djerickson/diy-smu/README.md

# diy-smu
Hardware and firmware for the DIY SMU project: Source Measure Unit
7/3 This is first attempt at Github
7/11 added Nextion
7/11 Made public
