djerickson/diy-smu/Hardware/SMU_BOM.xls

Sheet: MBoard
RefDes | Value | Name | Manufacturer | MPN | Qty | $ | $ | Notes | Availability Notes
C1, C6, C7 | 47uf 25V | CAPAE_6.6x6.6h5.7 | Panasonic | EEE-1EA470SP | 3 | $0.25 | $0.75
C2, C3, C4, C8, C12, C13, C17 | 4.7u 25V | CAP_0805 |  |  | 6 | $0.10 | $0.60 | Rev1: C17 || .1uF
C9 | 4.7u 25V 4mm |  |  | UWX1E4R7MCL1GB | 1 | $0.20 | $0.20 | High ESR: Reversed!
C5 | .01 1206 HiV | CAP_1206 |  | C1206X103MCRAC7800 | 1 | $1.00 | $1.00
C10, C18, C19, C20, C25, C27 | 1000p NPO | CAP_0805 |  |  | 6 | $0.05 | $0.30
C11, C14, C15, C16, C17, C21, C22, C23, C24, C29, C30, C31, C32, C33, C35, C36, C37, C43, C44, C45, C46, C47, C49, C50, C52 | .1u 50V | CAP_0805 |  |  | 25 | $0.02 | $0.50
C26, C28, C34 | 15p NPO | CAP_0805 |  |  | 3 | $0.10 | $0.30
C38 | 100p NPO | CAP_0805 |  |  | 1 | $0.10 | $0.10
C39, C40, C41 | 270p NPO | CAP_0805 |  |  | 3 | $0.10 | $0.30
C53 C54 | 270p NPO 500V | CAP_1206 |  | CL31C271JGFNNNE | 2 | $0.10 | $0.20
C48 | 150p NPO | CAP_0805 |  |  | 1 | $0.10 | $0.10
C51, C42 | 22p NPO 100V | CAP_0805 |  |  | 1 | $0.10 | $0.10
C55 DNI | 22p NPO 500V | CAP_1206 | Yageo | CC1206JRNPOBBN220 | 1 | $0.10 | $0.10
D1, D2 | BAV99 100V 215mA | SOT23 | ON | BAV99LT1 | 2 | $0.10 | $0.20
D3, D5, D6, D7 | BAV199 | SOT23 | Nexperia | BAV199.215 | 4 | $0.10 | $0.40 | Low Leakage, serial
D4 | BAV170 | SOT23 | Diodes | BAV170Q | 1 | $0.10 | $0.10
J1 | 14 pin box Hdr | HDRF-2x7 | On Shore Technology | 302-S141 (https://www.digikey.com/product-detail/en/on-shore-technology-inc/302-S141/ED10522-ND/2794233) | 1 | $0.50 | $0.50
J2 | 6p .1" Hdr |  | Molex KK | WM2704-ND‎ | 1 | $1.00 | $1.00
J3 | 6p .15" M |  | On Shore Technology | OSTOQ063251 (https://www.digikey.com/product-detail/en/on-shore-technology-inc/OSTOQ063251/ED2812-ND/1588129) | 1 | $1.00 | $1.00
J4 | 3p .15" M |  | On Shore Technology | OSTOQ033251 (https://www.digikey.com/product-detail/en/on-shore-technology-inc/OSTOQ063251/ED2812-ND/1588129) | 1 | $0.50 | $0.50
K2 | 1.5 ohm SW | AQY221R | Panasonic |  | 1 | $4.00 | $4.00 | 100mA range
K3 | 8 ohm SW | TLP170D | Toshiba |  | 1 | $1.50 | $1.50 | 400V 8 ohms
K1 DNI | Low ohm SW |  |  |  | 0 | $1.66 | $0.00 | For 1A range
K6 | .8 ohm SW | CPC1018N | IXYS |  | 1 | $2.00 | $2.00 | For 1.5V range
K4, K5 |  | RELAY2_DPDT | Kemet | EC2-5NU | 2 | $1.50 | $3.00 | 200V 2A DPDT
L1 | 100uH CM Choke | SRF1260A | Bourns | DR331-105 | 1 | $0.80 | $0.80 | Install L1 or FB2 and R78-80
FB1 | FB 600 ohm | RES_1210 | Taiyo Yuden | FBMH3225HM601NT | 0 | $0.25 | $0.00 | Install L1 or FB2 and R78-80
Q1, Q2 | MMBT3904 | SOT-23 | Philips-NXP | MMBT3904 | 2 | $0.10 | $0.20
R4, R5, R9, R11, R12, R13, R15, R16, R18, R19, R20, R21, R22, R23, R24, R25, R26, R54 | 10K .1% | RES_0805 |  |  | 18 | $0.10 | $1.80
R51, R52, R53, R55 | 10K .01% | RES_0805 |  |  | 4 | $0.50 | $2.00 | R53-R51 and R55-R52 0.01% matched
R1, R2, R3, R28, R33, R48, R49, R60, R61, R66 | 10K 1% | RES_0805 |  |  | 10 | $0.02 | $0.20
R68 | 10K 1% 1206 | RES_1206 |  |  | 1 | $0.05 | $0.05
R31 | 20K .1% | RES_0805 |  |  | 1 | $0.10 | $0.10
R29, R34 | 20K 1% | RES_0805 |  |  | 2 | $0.02 | $0.04
R10, R14, R17 | 21.5K .1% | RES_0805 |  |  | 3 | $0.02 | $0.06
R64, R6, R8 | 22.1K .1% | RES_0805 |  |  | 3 | $0.02 | $0.06
R7 | 10K DNI | RES_0805 |  |  | 0 | $0.02 | $0.00
R30, R63, R67 | 4.99K 1% | RES_0805 |  |  | 3 | $0.02 | $0.06
R44 | 4.99K .1% | RES_0805 |  |  | 1 | $0.20 | $0.20
R35 | 200K 1206 | RES_0805 |  |  | 1 | $0.05 | $0.05
R27, R36, R37, R57, R62, R69, R70 | 2K 1% | RES_0805 |  |  | 7 | $0.02 | $0.14
R38, R39 | 2 ohm 1W (DNI) | RES_2512 |  |  | 0 | $0.40 | $0.00
R40, R41 | 100 .1% 1W | RES_2512 |  | RNCF2512TKY100R | 2 | $2.00 | $4.00 | 5ppm .01%
R42 | 499 .1% .25W | RES_1206 |  |  | 1 | $0.50 | $0.50
R43 | 5M 25ppm 1206 | RG3216P-5004-B-T1 (https://www.digikey.com/product-detail/en/susumu/RG3216P-5004-B-T1/408-2038-1-ND/7035421) | Susumu |  | 1 | $0.60 | $0.60
R45 | 49.9K .1% | RES_0805 |  |  | 1 | $0.20 | $0.20
R46 | 549K .1% | RES_0805 |  |  | 1 | $0.20 | $0.20 | 562K is OK
R47, R50, R56, R59 | 100K .1% | RES_0805 |  |  | 4 | $0.10 | $0.40
R58 | 1K 1% | RES_0805 |  |  | 1 | $0.02 | $0.02
R65 | 301K .1% 1206 | RES_1206 |  |  | 1 | $0.40 | $0.40
R74, R75 | 100K 1% 1206 | RES_1206 |  |  | 2 | $0.02 | $0.04
R76, R77 | 499 1% | RES_0805 |  |  | 2 | $0.02 | $0.04
R78, R79, R80 | 0 ohm 0805 | RES_0805 |  |  | 0 | $0.03 | $0.00 | Install L1 or FB2 and R78-80
R82, R83 | 49.9 1% | RES_0805 |  |  | 2 | $0.02 | $0.04
TP1, TP2, TP3, TP4, TP5 | DNI | TESTPOINT |  |  | 5 | $0.00 | $0.00
U1 | RS3-1215D | 3W_DC-DC | Recom | RS3-1215D | 1 | $14.00 | $14.00
U2 | LM1117 5V | SOT223 | ON Semi | NCP1117LPST50T3G | 1 | $0.50 | $0.50 | many other 1117's , >=15V input
U3 | Si8661 Isolator | Si8661BB, BC | Silicon Labs | Si8661BB, BC, -IS1 | 1 | $2.50 | $2.50 | SOIC Narrow, Watch default state | Stock limits
U4 | Dual 5V RRIO | OPA2340 | TI | OPA2340 | 1 | $2.00 | $2.00 |  | Stock exists 6/21
U5 | 2.5V Ref 3ppm | ADR421BRZ | Analog Devices | ADR421BRZ | 1 | $9.50 | $9.50 | 3ppm, .04% | Not a lot in stock.
U6 DNI |  | AT25160B_SOIC8 | Atmel | AT25160B_SOIC8 | 0 | $0.50 | $0.00 | Option…
U7, U8, U13, U12, U14, U19, U21 |  | OPA2140 OPA2145 | TI | OPA2140 OPA2145 | 7 | 6 3 | $21.00 | Precis 120uV, 1uV/C OPA2145 good sub, Cheaper | OPA2140 Long lead 11/21 OPA2145 in stock Digi and Mouser
U9 | Quad 16b DAC | AD5686RBRUZ | Analog Devices | AD5686RBRUZ | 1 | $16.00 | $16.00 | Reference not needed | B grade long lead
U10 | 24b S-D ADC | AD7190BRUZ | Analog Devices | AD7190BRUZ | 1 | $10.00 | $10.00 |  | OK 6/21
U11, U17, U18 | CMOS Switch | DG444 or DG441DY | AD, Maxim, Renesas | DG444 or DG441DY | 3 | $2.00 | $6.00 | DG441 has no VL | Stock exists 6/21
U15, U16 | Shift Register | 74HC595D | NXP-Philips | 74HC595D | 2 | $0.60 | $1.20
U20 | Single op-amp | TL071ACD | TI | TL071ACD | 1 | $0.50 | $0.50
U22, U23 | Single, low Ib | OPA140 | TI | OPA140 | 2 | $3.00 | $6.00 |  | Stock exists 6/21
U26 | 74HC1G14 | SC-74 / SOT23-5 |  | 74HC1G14G | 1 | $0.30 | $0.30
PCB |  | 3.5 x 8" |  |  | 1 | $10.00 | $10.00
Total |  |  |  |  |  |  | $130.45

Sheet: Amp Board
RefDes | Value | Name | Manufacturer | MPN | Quantity | $ | $ | Notes
C1, C2 | 470UF 200V | .4" LS 1" dia. | Rubycon Nichicon | 250MXG470MEFCSN25X30 LLS2E471MELA | 2 | $3.50 | $7.00 | LS10mm Dia 25mm H 32mm
C3, C5 | 1U 250V film .45 spacing | CAP300 | Pan | ECQ-E2105KB (https://www.digikey.com/product-detail/en/panasonic-electronic-components/ECQ-E2105KB/P10979-ND/295886) | 2 | $1.00 | $2.00 | Wrong lead spacing
C4, C6 | 470U 25V | CAPAE_8.35x8.35h6.2 |  | EMZS250ARA471MHA0G | 2 | $0.70 | $1.40
C8, C9, C10, C11 | 1000p 500V | CAP_1206 |  | CL31B102KGFNFNE | 4 | $0.15 | $0.60
C7, C12 | 2200p 500V | CAP_1206 | Samsung | CL31B222KGFNFNE | 2 | $0.15 | $0.30
D1, D2, D3, D4, D17, D18 |  | 1N4007 |  |  | 6 | $0.10 | $0.60
D5, D6, D9, D10, D11, D12, D15, D16 |  | BAV99LT1 | ON |  | 8 | $0.10 | $0.80
D7, D8 | 15V 5% 1W Zener | 1N4744A |  |  | 2 | $0.15 | $0.30
D9, D10 | LED Red, 5mm TH |  | Lite-On | LTL4223 | 2 | $0.20 | $0.40
J1 | 5.08mm header 5pos |  | OST | OSTOQ055451 OSTOQ055450 | 1 | $1.00 | $1.00 | Right Angle Vertical
J2 | 3.81mm screw terminal, 6pos |  | OST | OSTOQ063251 (https://www.digikey.com/product-detail/en/on-shore-technology-inc/OSTOQ063251/ED2812-ND/1588129) | 1 | $1.00 | $1.00 | RightAngle
J3 | 6pos KK Vert male, Gold | HDR-1x6 |  | WM2704-ND‎ | 1 | $1.00 | $1.00 | Vertical
Q1, Q2 | N-Fet 200V 5A TO220 | IRL620 | IR | MMBT3904 | 2 | $0.90 | $1.80 | 200V 5A .8ohm 350pF
Q3 | NPN 120V TO220 | TIP41C | ON | MMBT3906 | 1 | $0.60 | $0.60
Q4 | PNP 120V TO220 | TIP42C | ON | PZT2222 | 1 | $0.60 | $0.60
Q5, Q6 | P-Fet 200V 3.5A TO220 | IRF9620 | IR | PZT2907 | 2 | $0.90 | $1.80 | 200V 3.5A 1.5ohm 350pF
Q7 | NPN 40V SOT23 | MMBT3904 |  | MMBT3904 | 1 | $0.10 | $0.10
Q8 | PNP 40V SOT23 | MMBT3906 |  | MMBT3906 | 1 | $0.10 | $0.10
Q9 | NPN 40V SOT223 | PZT2222 |  | PZT2222 | 1 | $0.30 | $0.30
Q10 | PNP 40V SOT223 | PZT2907 |  | PZT2907 | 1 | $0.30 | $0.30
Q11, Q12 | N-FET 60V SOT23 | 2N7002 |  | 2N7002 | 2 | $0.20 | $0.40 | Rev3
R1, R2 | 30.1 Ohm 5% .5W 1206 | RES_1206 | Yageo | RC1206JR-0730RL | 2 | $0.10 | $0.20
R3, R4, R6, R8 | 2.2M 1206 | RES_1206 | Yageo |  | 4 | $0.10 | $0.40
R5, R7 | 1M 1206 | RES_1206 | Yageo |  | 2 | $0.10 | $0.20
R9, R16 | 25 1W 2512 | RES_2512 | Yageo |  | 2 | $0.10 | $0.20
R11, R13, R12 | 1k | RES_0805 | Yageo |  | 3 | $0.02 | $0.06 | Rev3
R10, R17, R19 | 249 1% | RES_0805 | Yageo |  | 3 | $0.02 | $0.06
R20, R21, R22, R23 | 49.9 ohm 1% | RES_0805 | Yageo |  | 4 | $0.02 | $0.08
R18, R32 | 2K 1% 1W 2512 | RES_2512 | Yageo | AC2512JK-072KL | 2 | $0.30 | $0.60
R14, R15 | 100K 5% 1W 2512 | RES_2512 |  | AC2512JK-07100KL | 2 | $0.30 | $0.60
R24, R25 | 49.9K | RES_0805 |  |  | 2 | $0.02 | $0.04 | Rev3
PCB Amp Rev3 |  | 7.25 x 1.9" 184.15 x 48.26mm |  |  | 1 | $4.00 | $4.00
 |  |  |  |  |  |  | $28.84

Sheet: CPU Board
RefDes | Value | Name | Manufacturer | MPN | Qty | $ | $ | Notes
C3, C6, C8 | .1u 0805 | CAP_0805 |  |  | 3 | $0.02 | $0.06
C4,C7, C12 | 10u 25V 0805 | CAP_0805 |  |  | 3 | $0.10 | $0.30
D1 |  | BAV170 | NXP-Philips |  | 1 | $0.10 | $0.10
J2 | 14 pin box Hdr | HDRF-2x7 | On Shore Technology | 302-S141 (https://www.digikey.com/product-detail/en/on-shore-technology-inc/302-S141/ED10522-ND/2794233) | 1 | $0.50 | $0.50
JU2 | 14 pin female header, 0.1" |  |  |  | 2 | $0.50 | $1.00
J12V | 2pin KK Gold, Straight |  |  | WM2700 | 1 | $0.30 | $0.30
JFAN | 3pin KK Gold, Straight |  |  | WM2701 | 1 | $0.40 | $0.40
JLCD | 4pin KK Gold, Straight |  |  | WM2700 | 1 | $0.50 | $0.50
Q1 |  | MMBT3906 | NXP-Philips |  | 1 | $0.10 | $0.10
Q5 |  | MMBT3904 | NXP-Philips |  | 1 | $0.10 | $0.10
R1, R2, R26 | 2.2K 0805 | RES_0805 |  |  | 3 | $0.02 | $0.06
S1 |  | ENC_SW | TT | EN11-HSM1BF20 | 1 | $1.20 | $1.20
S2, S3, S4, S5, S6, S7, SWONOFF | Switch, 6mm Tactile |  | E-Switch | TL1105SPF160Q | 7 | $0.25 | $1.75
 | Round Caps, Grey |  | E-Switch | 1RLGR | 7 | $0.25 | $1.75
TP+12, TPGND |  | TESTPOINT |  |  | 2 | $0.00 | $0.00
U1 | 7805, D2 PAK | MC7805CD2T | ON Semiconductor |  | 1 | $0.50 | $0.50
U2 | Teensy 3.2 with pins | Teensy3.2 |  |  | 1 | $20.00 | $20.00
PCB 89x74mm |  |  |  |  | 1 | $3.00 | $3.00
Total |  |  |  |  |  |  | $31.62

Sheet: Cables
Cable | Conn1 | Conn2 | Pin | Colors | Wire | Length unstripped (in) | Notes
12V | KK-2 | PS-, Strip 0.4" | 1 | Black | 22AWG | 6.5
 |  | PS+, Strip 0.4" | 2 | Red | 22AWG
14 Ribbon | 14 Ribbon | 14 Ribbon | All | n/a | .05" Ribbon | 11.5 | 2 folds
LCD | KK-4 | LCD Hirose | 1 | Blk | 24AWG | 4.0 | Cable comes with LCD. Cut to length
 |  |  | 2 | Yel | 24AWG | 4.0
 |  |  | 3 | Blu | 24AWG | 4.0
 |  |  | 4 | Red | 24AWG | 4.0
Amp IN | KK-6 | KK-6 | 1 | Blk | 22AWG | 6.0
 |  |  | 2 | Red | 22AWG
 |  |  | 3 | Blk | 22AWG
 |  |  | 4 | Yel | 22AWG
 |  |  | 5 | Blu | 22AWG
 |  |  | 6 | n/c
Out+ | P4: 3 pin 0.381" Scr. | 5-way, Red, FHI | 1 | Org
 |  | 5-way, Red, SHI | 2 | Red
 |  | 5-way, Yel, GHI | 3 | Yel
Out- | P3: 6 pin 0.381" Scr. | P2: 6 pin 0.381" Scr. | 1 | Org
 |  | P2: 6 pin 0.381" Scr. | 2 | Red
 |  | P2: 6 pin 0.381" Scr. | 3 | Yel
 |  | 5-way, Blk, FLO | 4
 |  | 5-way, Blk, SLO | 5
AC IN | Red Spade | PS GND, Strip .4" |  | Grn/Yel
 | Red Spade, RA | AC SW | 2 | Blk
 | Red Spade, RA | PS N, Strip 0.4" |  | Wht
 | AC SW | PS L, Strip 0.4" | 1 | Blk
T1 Pri: 120V |  |  |  | Wht |  |  | Splice Wht+ORG+White 22AWG
 |  |  |  | Org
 |  |  |  | Brn |  |  | Splice Blak+Brn+Blk 22AWG
 |  |  |  | Blk
T1 Pri: 240V |  |  |  | Wht
 |  |  |  | Org
 |  |  |  | Brn
 |  |  |  | Blk
T1 Sec | P1" 0.2" 5 pin Scr |  | 1 | Grn
 |  |  | 2 | Blu
 |  |  | 3 | n/c
 |  |  | 4 | Yel
 |  |  | 5 | Red

Sheet: System
RefDes | Value | Manufacturer | MPN | Quantity | $ | $ | Notes
T1 | 120V x 2 Med Grade 25-50W Transformer | Talema Triad | 0050MD-1-003 VPM240-100 | 1 | $35.00 | $35.00
HS1 | Heat Sink 2.5" x 7" x .25" Alum 6061 bar | Metals Depot |  | 1 | $10.00 | $10.00 | Approx cost. 8 tapped holes
 | TO220 Thermal pads | Chomerics | 60-11-D397-1674 | 6 | $0.50 | $3.00
 | #4 shoulder washers 0.230, 0.145, 0.45 | Essentra | MNI-4-3 12SWS0234 | 6 | $0.30 | $1.80 | .145 max hole in transistors
 | #4-40 screws, 3/8" SS |  |  | 6 | $0.10 | $0.60
HW | Standoff 1/2" 4-40 F-F 0.188 Hex |  |  | 5 | $0.30 | $1.50 | For Amp board
 | Standoff 1" 4-40 F-F 0.188 Hex |  |  | 6 | $0.30 | $1.80 | For Main board
 | Standoff 1" 4-40 M-F 0.188 Hex |  |  | 6 | $0.30 | $1.80 | For Main board
 | Standoff 5/16" 4-40 F-F 0.188 Hex |  |  | 2 | $0.30 | $0.60 | For CPU Board
 | Standoff 1/4" 2-56 F-F 0.188 Hex |  |  | 4 | $0.30 | $1.20 | For LCD
 | Screw, M4 x 6mm Binder head Hex drive |  |  | 4 | $0.25 | $1.00 | Rear panel
 | Screw, M4 Hex, pretty |  |  | 4 | $0.25 | $1.00 | Front panel
 | Screw, M4 x 12mm Binder head Hex drive |  |  | 5 | $0.25 | $1.25 | Bottom to rails
 | Nuts, M4 Kept |  |  | 5 | $0.25 | $1.25 | Bottom to rails
 | Screw 4-40 x 1/4" SS, PH |  |  | 28 | $0.05 | $1.40 | Amp and Main boards, heat sink
 | Screw M3 x 6mm, PH |  |  | 2 | $0.05 | $0.10 | Power Supply
 | Screw 4-40 x 3/8" SS, FH |  |  | 2 | $0.10 | $0.20 | AC In
 | Screw, Fan, self tapping |  |  | 4 | $0.10 | $0.40 | Fan
 | Screw 2-56 x 3/16 PH |  |  | 8 | $0.10 | $0.80 | LCD
Connectors | 5.08mm Term Block Plug 5pos | OST | OSTTJ055153 | 1 | $2.00 | $2.00
 | 3.81 plug screw 3pos | Amphenol | TJ0331530000G | 1 | $0.80 | $0.80
 | 3.81 plug screw 6pos | Amphenol | TJ0631530000G | 2 | $1.20 | $2.40
 | .1" KK 6pos, gold pins | Molex | WM2312-ND | 10 | $0.15 | $1.50
 | Conn Socket 14pos IDC Gold | OST | 101-146 | 2 | $0.40 | $0.80
Banana Jacks | Black, Safety type | Cal Test | CT2910-1 | 2 | $1.50 | $3.00 | Lo Out and Sense
Banana Jacks | Red, Safety type | Cal Test | CT2910-2 | 2 | $1.50 | $3.00 | Hi Out and Sense
Banana Jacks | Yellow, Safety type | Cal Test | CT2910-4 | 1 | $1.50 | $1.50 | Guard
Banana Jacks | Green, Safety type | Cal Test | CT2910-5 | 1 | $1.50 | $1.50 | Ground
12V 1A PS | 12V Enclosed power supply | MeanWell TDK | RS-15-12 LS25-12 | 1 | $16.00 | $16.00 | Meanwell is cheaper TDK lower noise, $$$
AC In | AC in with fuse, switch, filter | Delta | 06AK2 | 0 | $18.00 | $0.00 | For Hammond chassis
AC In | AC in with fuse, filter | Ohmite | AF-B01-S | 1 | $9.00 | $9.00 | For 1/2 Rack chassis
AC SW | SPDT ON/ON | C&K |  | 1 | $2.00 | $2.00 | Better switch?
Enclosure
Top Rails | 280mm shaft beam, 8mm | Gobilda | 1119-0035-0280 | 2 | $6.00 | $12.00 | Top rails need chamfers
Bottom Rails | 280mm beam, 8mm Sq | Gobilda | 1106-0035-0280 | 2 | $6.00 | $12.00 | Can use 4x 1119 instead of 1106
Top cover | Al, 1.0 x ~300 x 280 x 79mm, 4 holes |  |  | 1 | $20.00 | $20.00 | 3 sided bend, cooling holes
Bottom | Al, 1.5 x 206 x 280mm, 16 holes |  |  | 1 | $5.00 | $5.00
Front Panel | 1.5 212 x 86mm | PCBWay |  | 1 | $8.00 | $8.00
Rear Panel | 1.5 212 x 86mm | PCBWay |  | 1 | $8.00 | $8.00
Fan | 60mm x 15mm 12V, 12-16 CFM | CUI | 6015V-122-145 | 1 | $6.00 | $6.00
Main Board |  |  |  | 1 | $130.45 | $130.45
Amp Board |  |  |  | 1 | $28.84 | $28.84
CPU Board |  |  |  | 1 | $31.62 | $31.62
LCD | Nextion 3.5" touch screen |  |  | 1 | $35.00 | $35.00
Total |  |  |  |  |  | $405.11
