djerickson/diy-smu/Hardware/AmpBoardSchR2.pdf

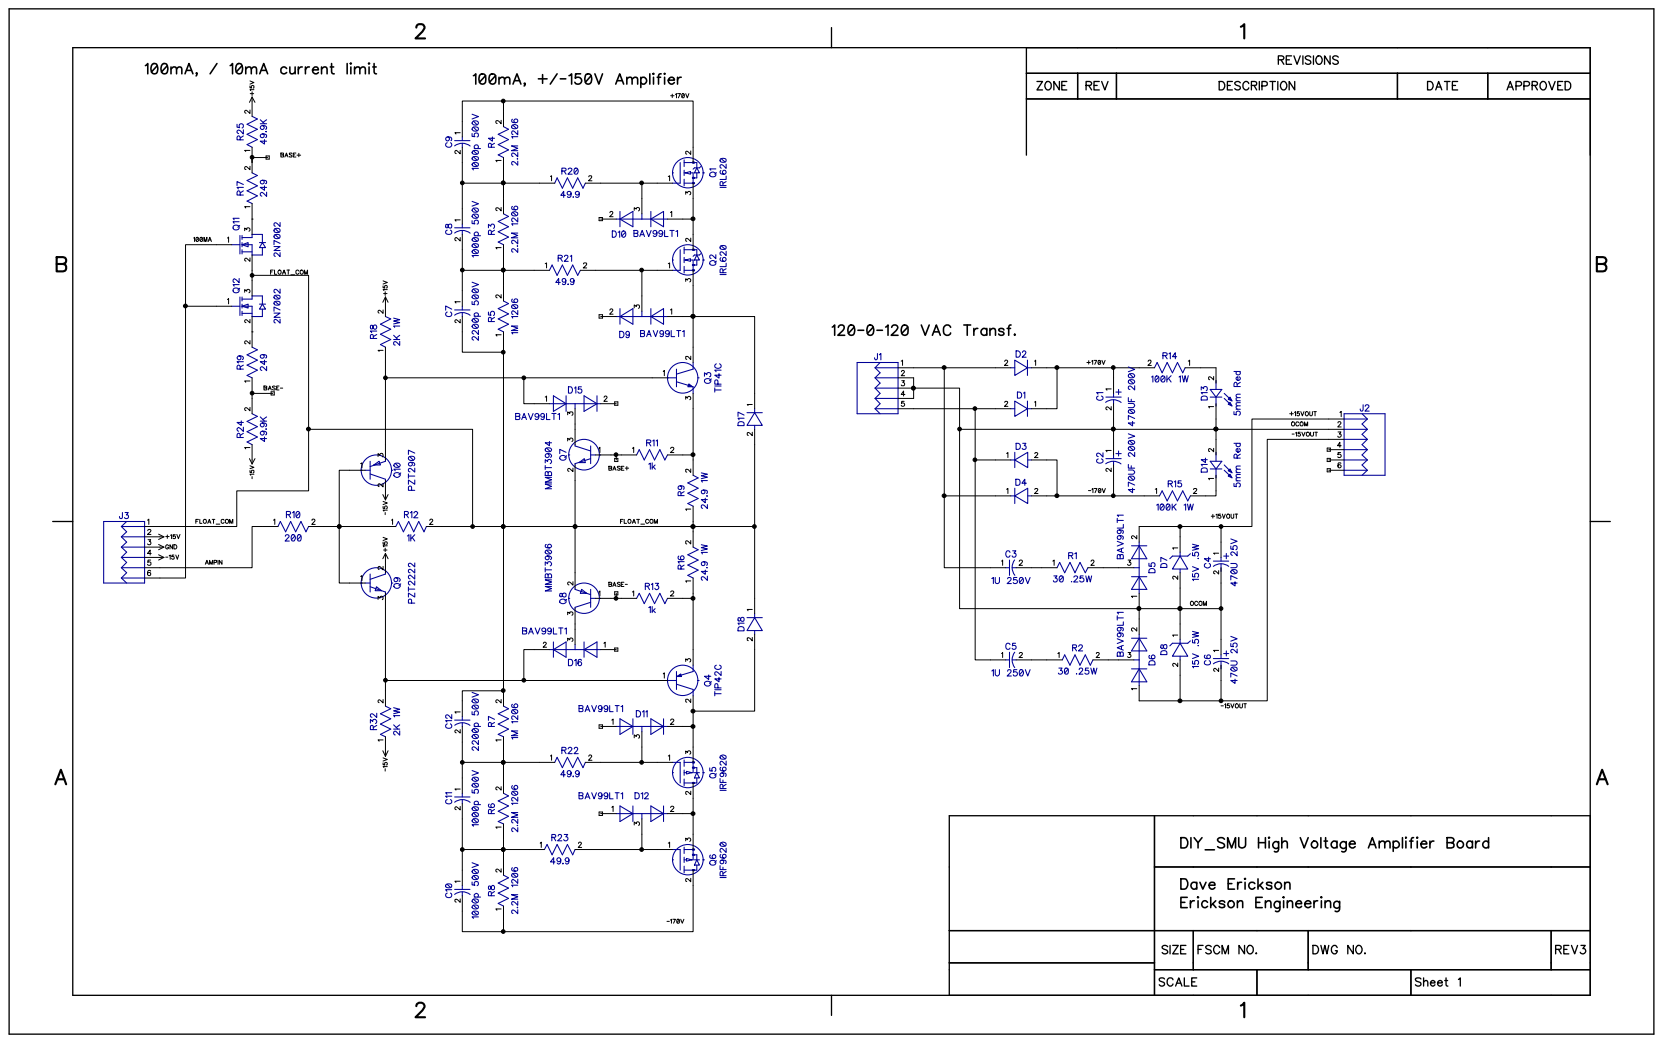
[picture p1: page 1]
