djerickson/diy-smu/Hardware/MainBoardSchR2a.pdf

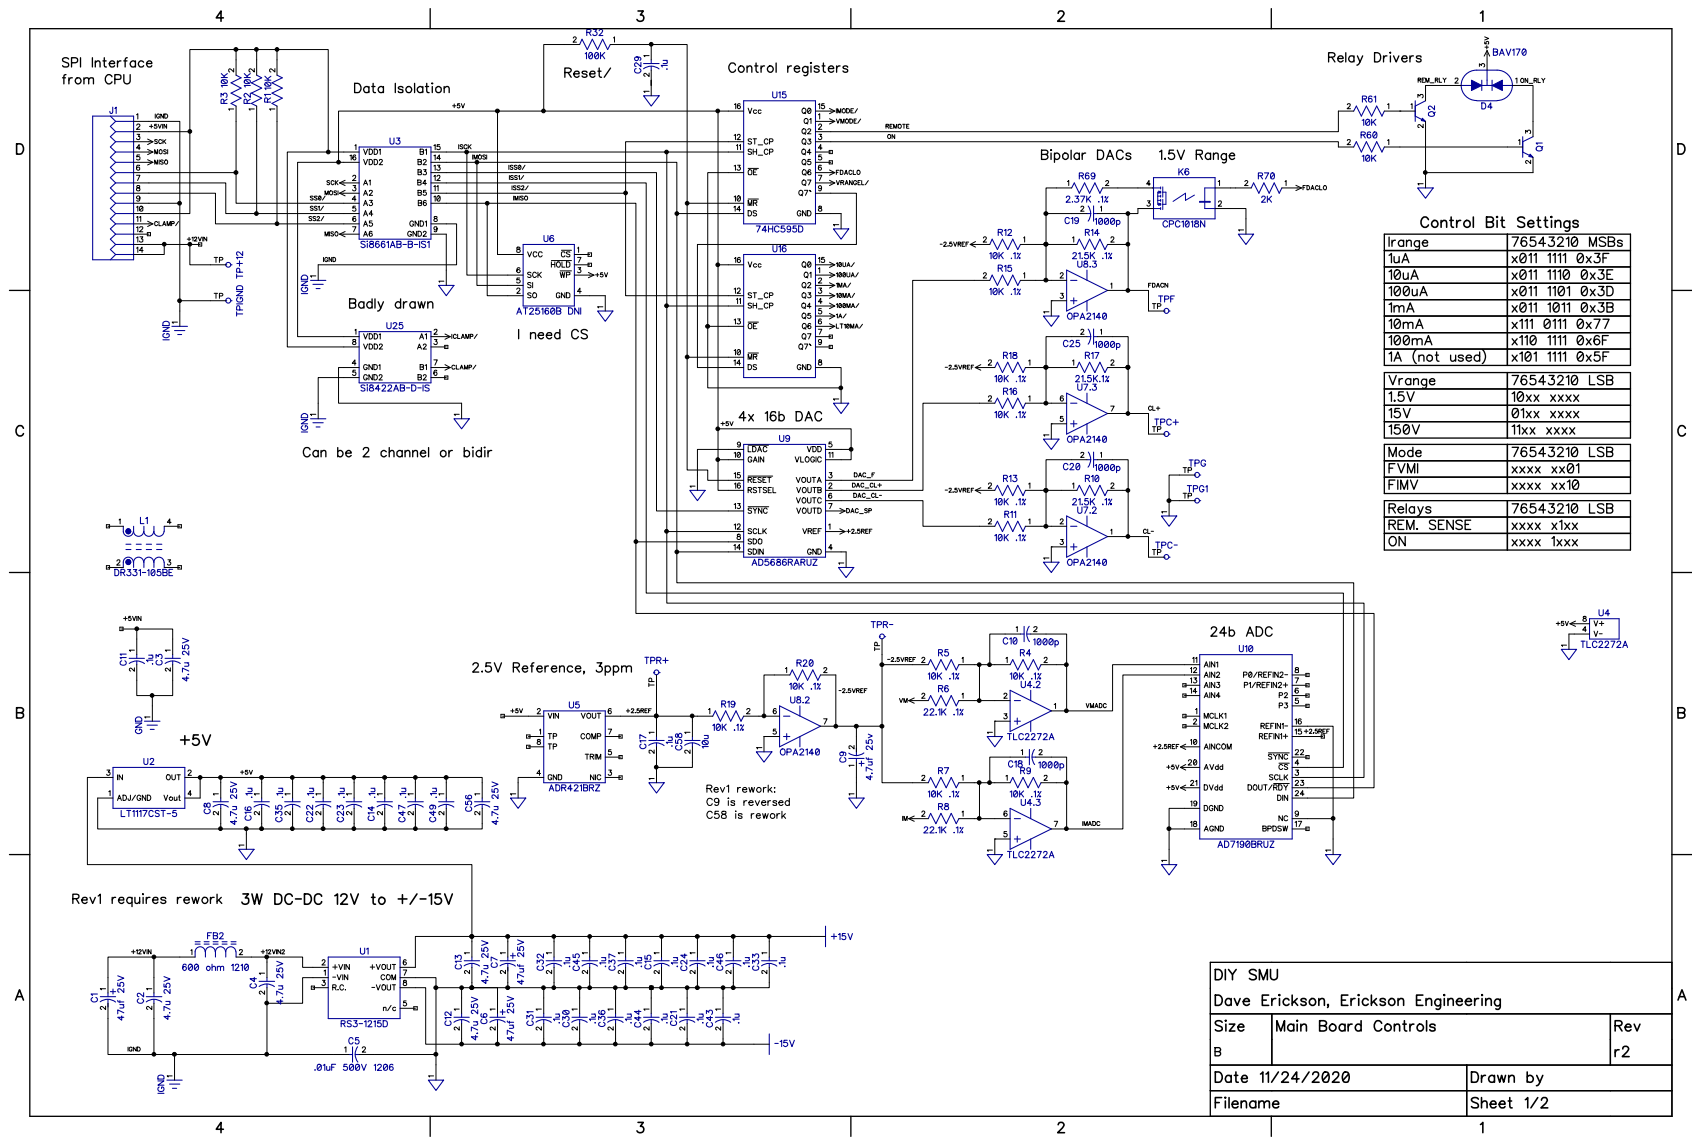
[picture p2: page 1]

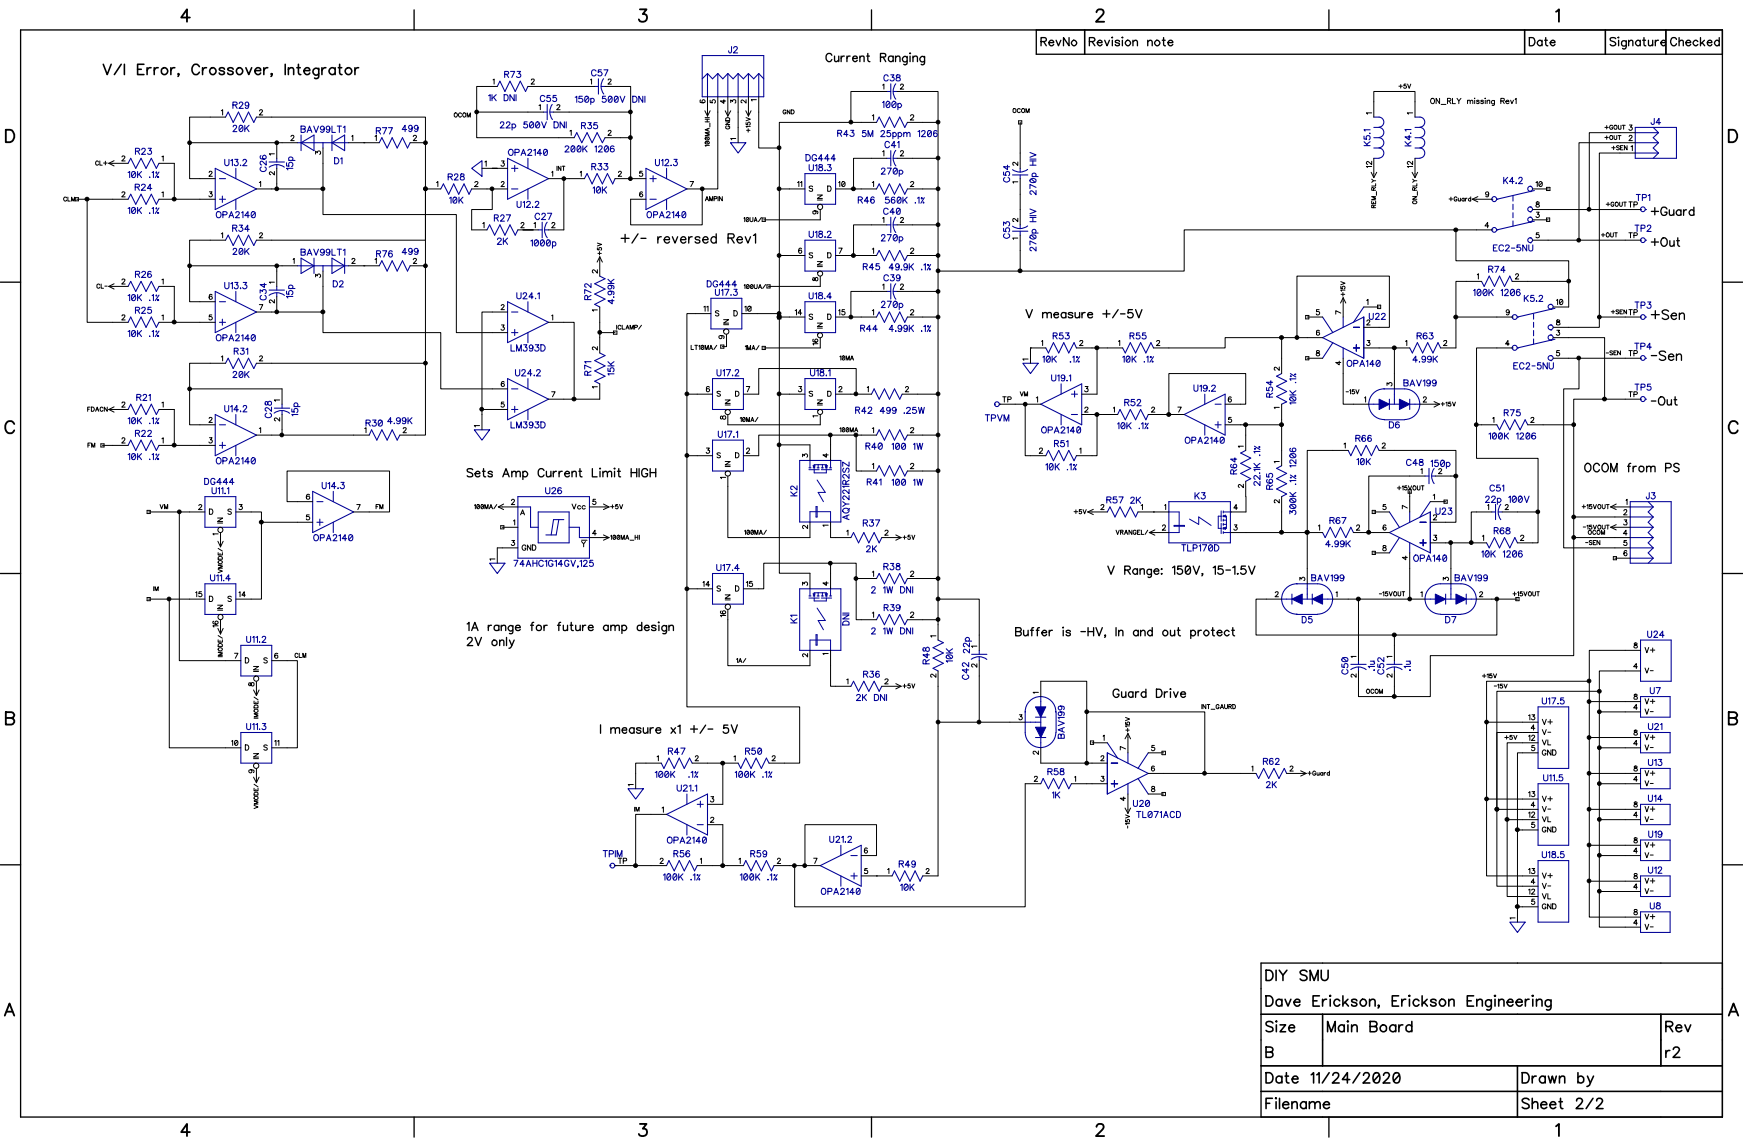
[picture p3: page 2]
