djerickson/diy-smu/Hardware/MainBoardSchR2b.pdf

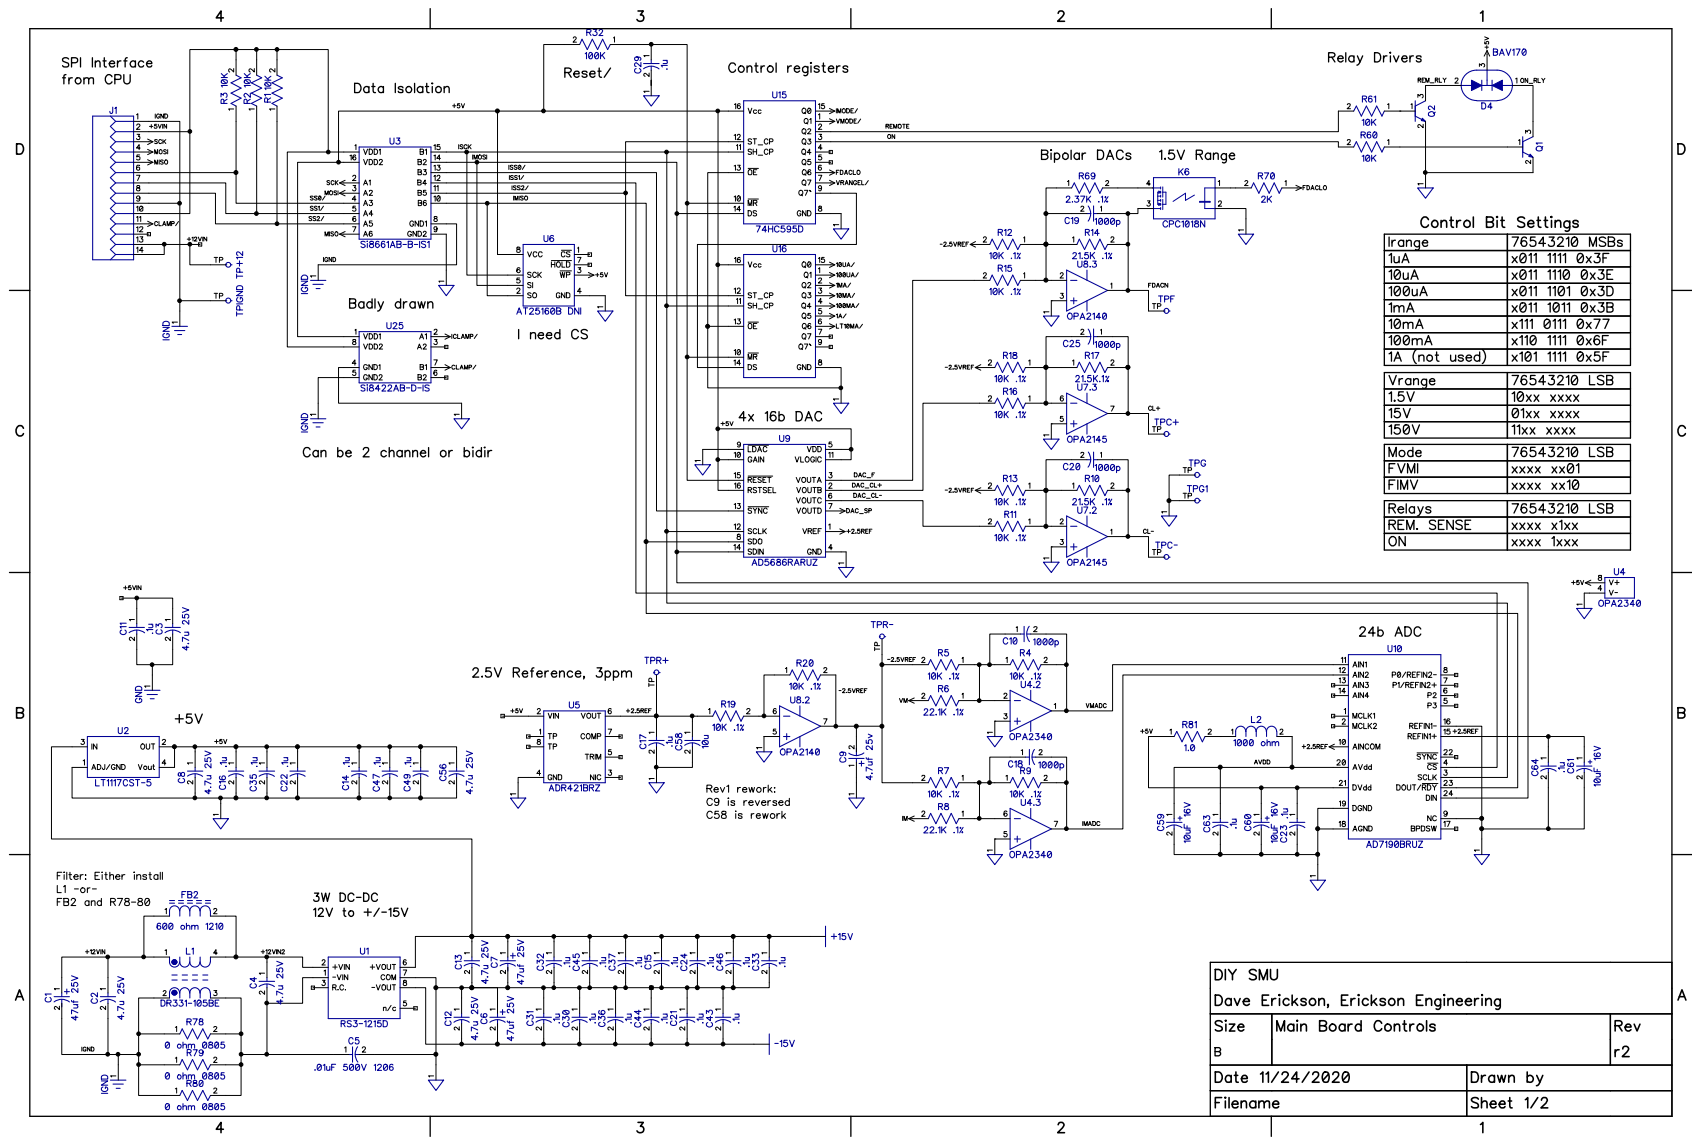
[picture p4: page 1]

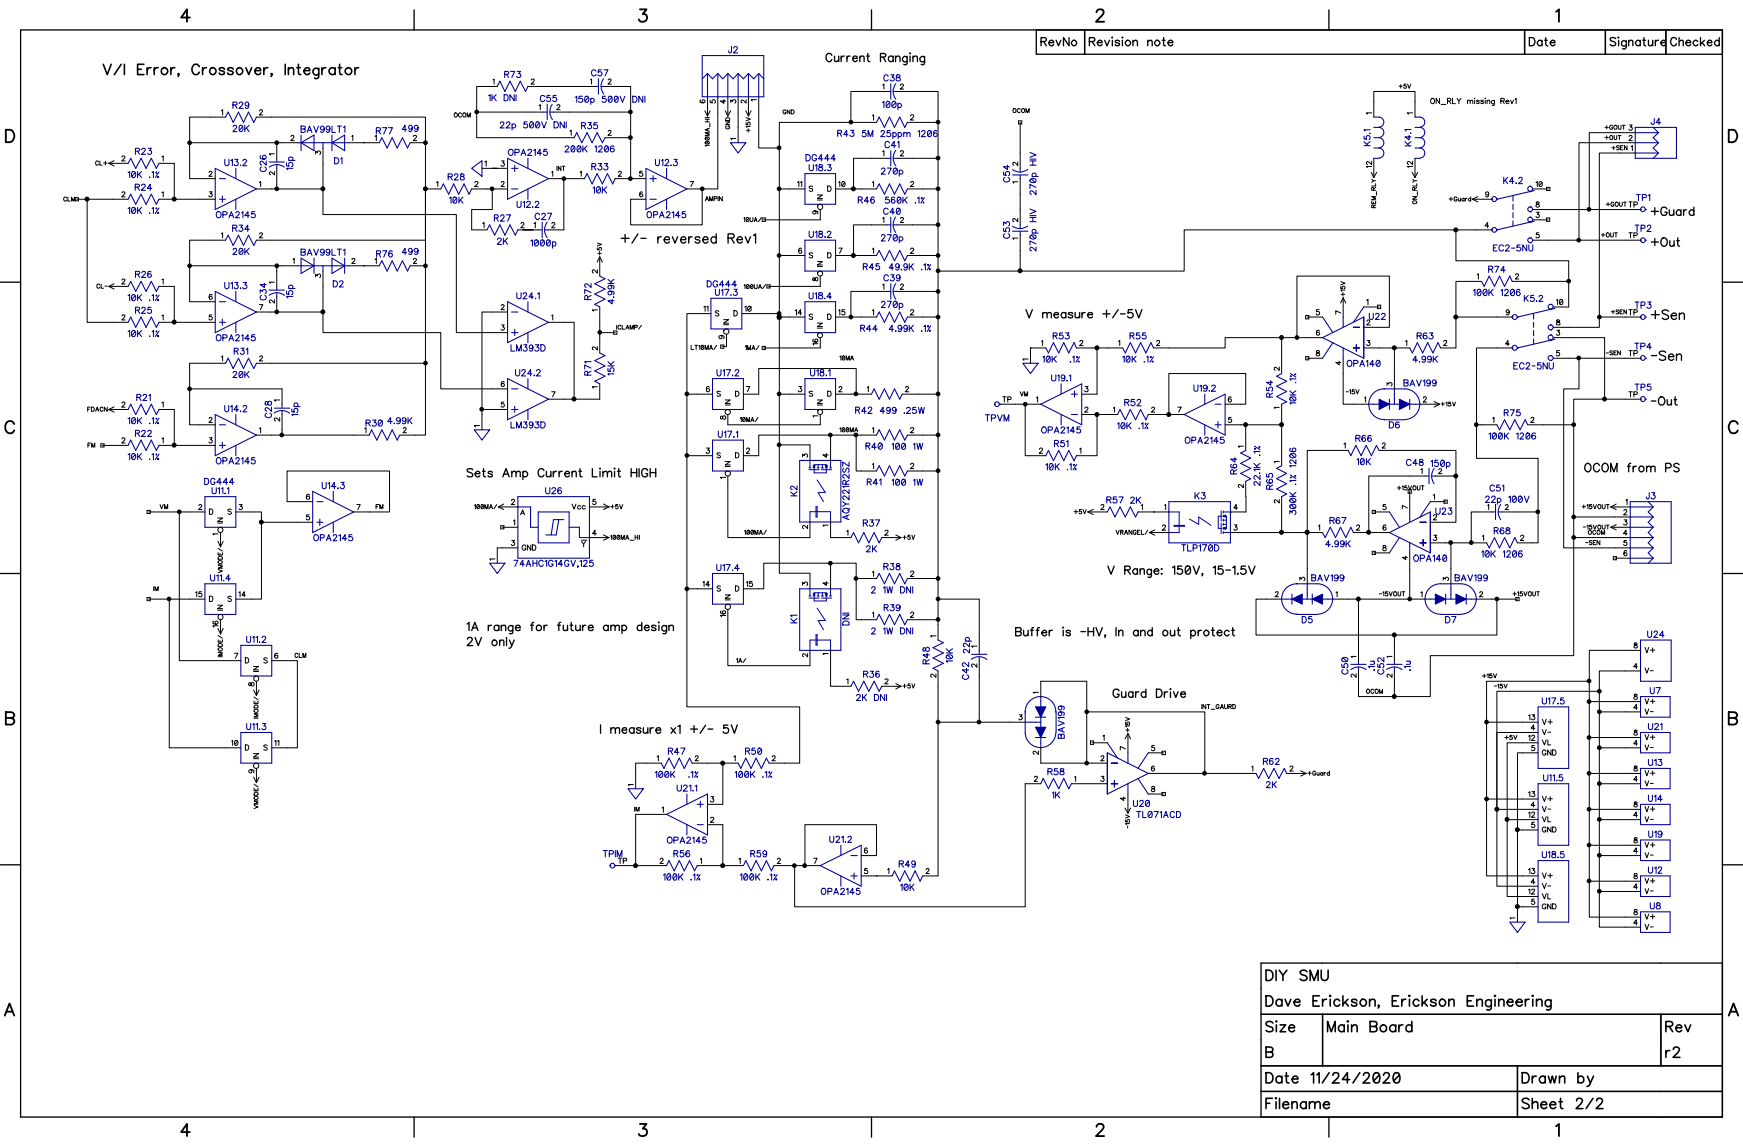
[picture p5: page 2]
