djerickson/diy-smu/(list of files, drawings)

Other design files:
Hardware/FP2.dip
Hardware/RP1.dip
Hardware/SMU 1 Cross.dch
Hardware/SMU AmpRev3.dch
Hardware/SMU AmpRev3.dip
Hardware/SMU Cpu1.dch
Hardware/SMU_CPU1.dip
Hardware/SMURev2.dip
